TiltyTable/tiltytable/design/assets/site/elevator-mechanism-iso.png

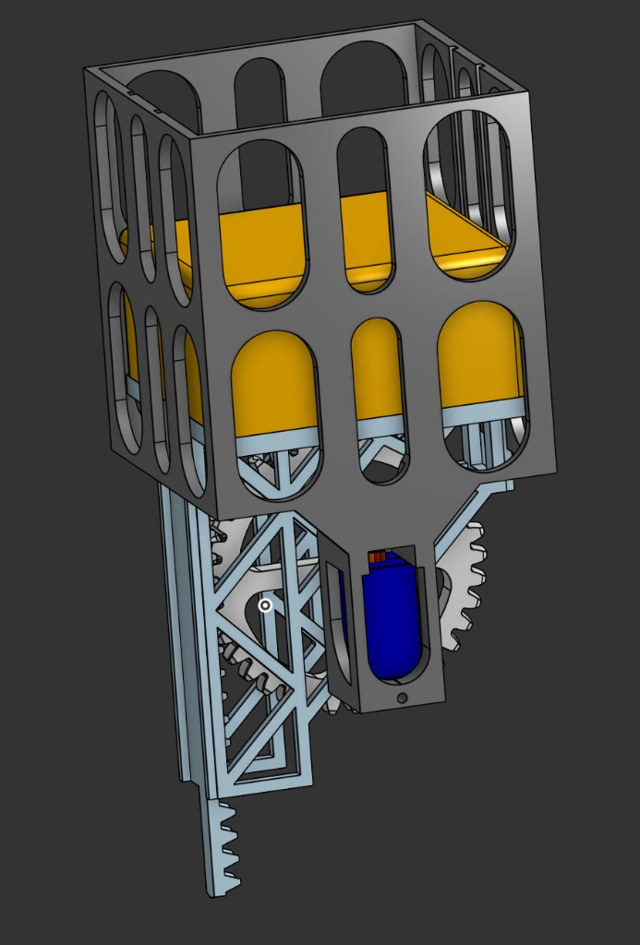
design/assets/site/elevator-mechanism-iso.png
