TiltyTable/tiltytable/docs/assets/stills/build-still-1.jpg

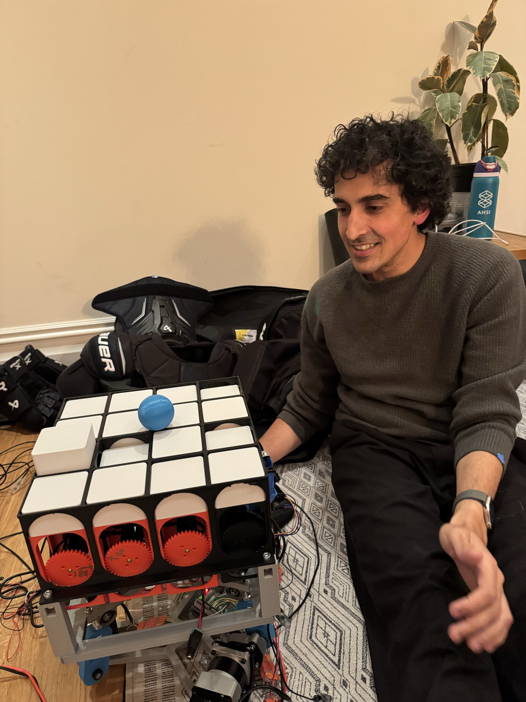
docs/assets/stills/build-still-1.jpg
