TiltyTable/tiltytable/README.md

# TiltyTable arcade game

TiltyTable is a physical 12×12 marble-maze arcade game. A USB trackball tilts
a three-motor Stewart platform, an Arduino-controlled module grid raises and
recesses tiles and drives their LEDs, an Azure Kinect tracks the ball and the
moving table, and a Flask arcade server runs the levels, scoring, projector UI,
and module animations.

This README describes the supported game stack. Retired direct-serial Stewart
programs and firmware are kept under `archive/stewart_legacy/` and must not be
used while the persistent Stewart supervisor is running.

## What the complete game needs

### Hardware and firmware

| Device | Stable device path | Firmware used during the game | Board/FQBN |
| --- | --- | --- | --- |
| Stewart controller | `/dev/arduino-stewart` | `arduino/uim5756_stewart_r4/` | Uno R4 WiFi, `arduino:renesas_uno:unor4wifi` |
| Module servo + LED controller | `/dev/arduino-modules` | `arduino/servo_calib/` | Uno R4 Minima, `arduino:renesas_uno:minima` |
| Trackball | Linux `event-mouse` device | No firmware from this repository | USB HID `13ba:0018` |
| Ball/table camera | Azure Kinect device 0 | Azure Kinect Sensor SDK | USB camera + IMU |

`arduino/uim5756pm_config/` is a temporary one-motor setup sketch. It is used
only to configure each UIM5756PM motor to MCS=4; it is not game firmware.

### Programs running for a complete live game

Start the complete host stack with one launcher. The launcher ensures the
persistent Stewart serial supervisor is running, then starts the integrated
arcade process and projector kiosk:

| Process | Purpose | Owns |
| --- | --- | --- |
| `stewart_supervisor.py` | Persistent serial owner and motion lease server | `/dev/arduino-stewart` |
| `arcade.server` (started by `run_arcade.sh`) | Kinect capture and ball/table tracking; trackball and Stewart control; level logic, scoring, servos, LEDs, and projector UI | Azure Kinect; trackball; supervisor motion lease; `/dev/arduino-modules`; HTTP `:8080` by default |

Do not start `kinect_web_control.py` or a standalone
`stewart_platform_control_*.py` beside the live arcade. Those remain useful as
diagnostic programs, but the arcade owns those devices during a game.

## Essential source and configuration

| Game element | Runtime source | Required configuration |
| --- | --- | --- |
| Trackball + Stewart position control | `arcade/stewart_tilt.py`, `stewart_platform_control_position.py`, `stewart_platform_control_common.py` | Controller defaults; Arduino EEPROM position/calibration |
| Trackball + Stewart velocity control | `stewart_platform_control_velocity.py`, `stewart_platform_control_common.py` | CLI gain, decay, signs, and limits |
| Stewart IK | `analysis/stewart_exp_kinematics.py` | Geometry constants in that module |
| Stewart serial ownership | `stewart_supervisor.py`, `stewart_supervisor_client.py`, `stewart_exp_probe.py` | Supervisor Unix socket; Arduino EEPROM position/calibration |
| Module servos and LEDs | `arcade/hardware.py`, `game_runner.py` | Grid, servo, palette, and LED calibration JSON files below |
| Azure Kinect ball tracking | `arcade/ball_adapters.py`, `kinect_web_control.py`, `ball_tracker.py`, `camera_geometry.py` | `config.json` ball settings |
| Continuous table tracking | `table_pose.py` | `config.json` marker dimensions/threshold; five measured marker locations in `TableGeometry._rebuild()` |
| Arcade game | `arcade/server.py`, `arcade/engine.py`, `arcade/survival_lava.py` | `arcade/levels.json`, `maps/arcade-level-*.json` |
| Arcade cabinet input | `arcade/stewart_tilt.py` | `arcade/config.json` trackball navigation sensitivity |
| Cabinet UI | `arcade/static/` | 854×480 browser kiosk launched by `run_arcade.sh` |

The live module grid requires all of these calibration files:

- `calibration/led_grid_config.json`: all 144 cells mapped to nine physical LED strands.
- `calibration/servo_grid_config.json`: all 144 cells mapped to PCA9685 address/channel pairs.
- `calibration/servo_config_0x40.json` through `servo_config_0x48.json`: recessed, neutral, and extended pulse widths for every mapped servo.
- `calibration/led_palette.json`: game color definitions.
- `calibration/led_color_cal.json`: per-cell/module LED color corrections.

Arcade preflight rejects live mode unless both grids cover 144 cells, all nine
LED strands exist, and every mapped servo has all three calibrated positions.

No active code imports anything under `archive/arduino/`.

### Present in the repository but not required at runtime

- `stewart_exp_probe.py`, `stewart_exp_tune.py`, and the files under
  `calibration/` are bring-up, calibration, and diagnostic tools. Module tools
  require the arcade to be stopped; Stewart tools require the trackball motion
  client to be stopped but normally keep using the supervisor.
- The experimental roller-ball controller is archived under
  `archive/stewart_legacy/python/`; use one of the two active
  `stewart_platform_control_*.py` programs instead.
- `game_runner.py` and `calibration/tilt_table_cli.py` are standalone
  module-grid tools. The arcade imports reusable pieces from `game_runner.py`,
  but neither CLI should run beside the live arcade server.
- `trackball_input_web.py` is a standalone input monitor, not a game service.
- `archive/camera/` contains the MindVision/UVC path and is not used by the Azure
  Kinect game stack.
- `archive/hardware/`, `depth_servo_control.py`, and `extrinsics.json` are older or
  optional experiments. Everything under `archive/arduino/` is outside the
  active game and calibration path.
- `docs/` and `design/` are project-site/design material, not runtime code.

## Host setup

Run commands from the repository root unless a command explicitly changes
directory.

```bash
python3 -m venv .venv
.venv/bin/pip install -r requirements.txt
```

The Azure Kinect path additionally requires the system Azure Kinect Sensor SDK
(`libk4a` and development files) and its Python wrapper:

```bash
.venv/bin/pip install pyk4a
```

The camera service must be able to import `pyk4a` and open device 0. It uses
the Kinect's factory IR camera calibration directly; `extrinsics.json` is not
part of the active ball/table tracking path. RGB capture is disabled, and the
tracker consumes and streams only Active Brightness images—not depth or RGB
frames. Azure Kinect still requires an active depth mode and its OpenGL-backed
depth engine to illuminate and produce Active Brightness; the paired depth
result is generated inside the SDK but is never materialized by this service.

Install Arduino cores and the two non-core sketch libraries:

```bash
arduino-cli core install arduino:renesas_uno
arduino-cli lib install MobaTools@3.1.0
arduino-cli lib install "Adafruit NeoPixel"
```

Install stable serial aliases and non-root trackball access:

```bash
sudo cp udev/99-tiltytable-arduinos.rules /etc/udev/rules.d/
sudo cp udev/99-tiltytable-rollerball.rules /etc/udev/rules.d/
sudo udevadm control --reload-rules
sudo udevadm trigger
sudo usermod -aG plugdev "$USER"
```

Log out and back in after changing group membership. Verify:

```bash
ls -l /dev/arduino-stewart /dev/arduino-modules
ls -l /dev/input/by-id/*event-mouse
```

## Flash the Arduinos

### Uno R4 Minima: module servos and LEDs

This is the only live module-grid sketch. It controls PCA9685 boards
`0x40`–`0x48` and all nine WS2812B strands over one 115200-baud connection.

```bash
arduino-cli compile --fqbn arduino:renesas_uno:minima arduino/servo_calib
arduino-cli upload -p /dev/arduino-modules \
  --fqbn arduino:renesas_uno:minima arduino/servo_calib
```

Do not flash any sketch under `archive/arduino/` for the live game.

### Uno R4 WiFi: configure the three Stewart motors once

The live Stewart firmware assumes every UIM5756PM is configured to **MCS=4**,
which corresponds to 16,000 host steps per crank revolution with the 20:1
gearbox. Mixed MCS settings invalidate all IK step targets.

Mechanically support the loaded platform, stop the supervisor, and connect
exactly one motor UART at a time as documented in
`arduino/uim5756pm_config/README.md`.

```bash
systemctl --user stop tiltytable-stewart-supervisor.service 2>/dev/null || true
arduino-cli compile --fqbn arduino:renesas_uno:unor4wifi arduino/uim5756pm_config
arduino-cli upload -p /dev/arduino-stewart \
  --fqbn arduino:renesas_uno:unor4wifi arduino/uim5756pm_config
arduino-cli monitor -p /dev/arduino-stewart -c baudrate=115200
```

For each of the three motors, issue `get`, then `set 4 CONFIRM`. Power-cycle the
motor supply and verify `get` reports MCS=4 for each motor before continuing.

### Uno R4 WiFi: flash the live Stewart executor

Keep the platform mechanically supported whenever uploading or reopening its
serial device.

```bash
arduino-cli compile --fqbn arduino:renesas_uno:unor4wifi arduino/uim5756_stewart_r4
arduino-cli upload -p /dev/arduino-stewart \
  --fqbn arduino:renesas_uno:unor4wifi arduino/uim5756_stewart_r4
```

After flashing, start the supervisor before using any Stewart Python tool.
Supported clients use its Unix socket and do not open the Arduino directly.

## One-time calibration and bring-up

Never run the arcade server, `game_runner.py`, or two module calibration tools
at the same time: each expects exclusive ownership of `/dev/arduino-modules`.

### 1. Module LED mapping

First confirm all nine strands and determine their real pixel counts:

```bash
.venv/bin/python3 calibration/led_strip_test.py \
  --port /dev/arduino-modules --together
```

Then tag each physical LED pixel to its 12×12 cell. This writes
`calibration/led_grid_config.json`:

```bash
.venv/bin/python3 calibration/led_cal_tool.py \
  --port /dev/arduino-modules
```

### 2. Per-servo motion envelopes

Calibrate recessed, neutral, and extended pulse widths for all nine PCA9685
boards. Run from `calibration/` because this tool's board-config defaults are
relative to its working directory:

```bash
cd calibration
../.venv/bin/python3 servo_tool.py \
  --port /dev/arduino-modules calibrate
cd ..
```

This updates `servo_config_0x40.json` through `servo_config_0x48.json`. Module
servos are pulse-then-release; do not leave them energized against a stop.

To pose-test the calibrated servos, start the interactive tester (its initial
selection is all modules), or run a position once for one module:

```bash
cd calibration
../.venv/bin/python3 servo_tool.py --port /dev/arduino-modules test
../.venv/bin/python3 servo_tool.py --port /dev/arduino-modules test extended --module 0x43
cd ..
```

Inside the tester, use `module all` or `module 0x43` to change the selection,
then enter `recessed`, `neutral`, or `extended`. Modules and servos are
commanded one after another without added pacing, and every servo is released
after it reaches the requested position.

### 3. Servo-to-cell mapping

Visually associate every PCA9685 channel with the LED cell that moves. This
writes `calibration/servo_grid_config.json`:

```bash
cd calibration
../.venv/bin/python3 servo_grid_cal_tool.py \
  --port /dev/arduino-modules
cd ..
```

### 4. LED color matching

Tune the game palette across modules with either the terminal tool or Tk GUI.
Both update `calibration/led_color_cal.json`:

```bash
.venv/bin/python3 calibration/led_color_cal_tool.py \
  --port /dev/arduino-modules

# Alternative GUI; requires python3-tk
.venv/bin/python3 calibration/led_color_cal_gui.py \
  --port /dev/arduino-modules
```

### 5. Validate the complete module grid

```bash
.venv/bin/python3 -m arcade.preflight \
  --hardware --module-port /dev/arduino-modules --port 8081
```

An optional physical smoke test is available, but it moves every calibrated
channel and should be run only with an operator watching the table:

```bash
.venv/bin/python3 calibration/quick_test.py /dev/arduino-modules
```

### 6. Stewart crank and physical-level calibration

Install and start the persistent supervisor:

```bash
mkdir -p ~/.config/systemd/user
cp systemd/tiltytable-stewart-supervisor.service ~/.config/systemd/user/
systemctl --user daemon-reload
systemctl --user enable --now tiltytable-stewart-supervisor.service
systemctl --user status tiltytable-stewart-supervisor.service
```

The supplied service contains absolute `/home/zipline/tiltytable` and
`/home/zipline/bin/arduino-cli` paths. Edit the copied service if the checkout
or `arduino-cli` lives elsewhere. Keep `Restart=no`: an automatic restart can
reopen serial while the platform is loaded.

The Freenove V5 WiFi USB bridge requires DTR asserted, so the supervisor and
supplied service default to `--dtr on`. Pass `--dtr off` explicitly for boards
where opening with DTR can reset the controller.

Confirm the firmware through a read-only supervisor lease:

```bash
.venv/bin/python3 stewart_exp_probe.py --check-firmware
```

Run the tuning session with the platform mechanically protected:

```bash
.venv/bin/python3 stewart_exp_tune.py
```

If Arduino `STATUS` is not calibrated, the tool starts interactive per-crank
vertical calibration. Runtime `nudge`, `profile`, `threshold`, and `agility`
commands operate only for the current session and do not create tuning state.
The active `stewart_platform_control_position.py` and
`stewart_platform_control_velocity.py` programs use their CLI settings and
firmware calibration directly.

Every supported motion client gets the current absolute motor positions from
the Arduino/supervisor during startup before constructing its initial IK pose.
The platform controllers resume that held pose by default. Pass
`--zero-on-start` to move to the canonical level pose before accepting input.
The live R4 executor and supervisor communicate at 230400 baud.
Position control defaults to 9 degrees maximum tilt, 0.04 degrees per input
count, 60 degrees/s crank speed, 500 degrees/s2 crank acceleration, zero input
deadband, a 90 Hz update rate, and no startup confirmation. Pass `--no-yes`
to require the `START` confirmation.

### 7. Azure Kinect ball and table tracking

Mount six retroreflective fiducials: one at each table corner and one more
on each of two adjacent edges, in the geometry documented at the top of
`table_pose.py`.
Verify the measured marker-center locations in `TableGeometry._rebuild()`;
the four corner fiducials define the cell-map bounds, so no separate table
length configuration is needed. Thresholds, ball radius, and camera settings
live in `config.json`.

The tracking algorithms are image-space-only. RGB capture is forced off, and
neither the integrated arcade nor the diagnostic camera page reads or streams
depth/RGB frames. `/stream/ir.mjpg`, `/stream/tracker.mjpg`, and
`/stream/pose.mjpg` contain only raw or annotated Active Brightness images.

Set `table_pose.marker_world_points` in `config.json` to the measured center
of each fiducial, in millimetres: `corner_origin`, `corner_x`, `corner_xy`,
`corner_y`, `edge_x`, and `edge_y`. Each value is `[x, y, z]` in the table
frame. Place the two edge markers on adjacent edges to break the square's
mirror ambiguity.

Start the camera service on port 8080:

```bash
.venv/bin/python3 kinect_web_control.py --http-port 8080
```

Open `http://127.0.0.1:8080/` and tune the marker and ball IR thresholds. The
service is ready for the game when these endpoints report table tracking and a
detected ball with a grid cell:

```bash
curl -s http://127.0.0.1:8080/api/pose/state
curl -s http://127.0.0.1:8080/api/state
```

`config.json` currently enables ball tracking. If a different config is used,
pass `--ball-tracking` or set `ball.ball_tracking` to `true`.

## Run the complete game

After completing hardware setup, calibration, and the one-time supervisor
installation above, launch the entire game from the repository root:

```bash
./run_arcade.sh
```

The launcher runs hardware preflight, starts the persistent Stewart supervisor
user service if needed, and starts one arcade process. That arcade process owns
the Azure Kinect tracker, trackball/Stewart motion client, module servos and
LEDs, game engine, HTTP server, and projector kiosk. It initializes Stewart IK
from the current Arduino motor positions and uses the firmware's EEPROM
calibration directly.

When launched from SSH, `run_arcade.sh` attaches the arcade process to the local
GPU-backed projector display (`:0`) before starting Kinect capture. The Azure
Kinect depth engine requires that OpenGL display even though the integrated
tracker does not consume depth frames or render preview windows; Active
Brightness illumination still comes from that engine. An SSH-forwarded display
such as `localhost:10.0` is not sufficient.

Set `TILTYTABLE_ARCADE_PORT` only when the default port `8080` is unavailable:

```bash
TILTYTABLE_ARCADE_PORT=8081 ./run_arcade.sh
```

Use `--no-kiosk` to run only the server and open
`http://127.0.0.1:8080/` manually (or the port selected with
`TILTYTABLE_ARCADE_PORT`).

Current game behavior:

- The arcade process exclusively drives module servos and LEDs.
- The in-process Stewart adapter reads the trackball and enables tilt during an
  active level.
- The in-process Kinect adapter drives the automatic Floor-is-Lava survival
  mechanics.

## Arcade diagnostics

Validate maps and Python behavior:

```bash
.venv/bin/python3 -m arcade.preflight --port 8081 --hardware
.venv/bin/python3 -m unittest discover -s tests -v
```

Apply one map without the arcade server (exclusive module access required):

```bash
.venv/bin/python3 game_runner.py maps/arcade-lava-survival.json --once
```

## Runtime ownership and shutdown

- Only `stewart_supervisor.py` opens `/dev/arduino-stewart`.
- Only one motion client may hold the supervisor motion lease.
- Only the arcade server or one calibration/diagnostic tool may open
  `/dev/arduino-modules`.
- Stop the arcade before module calibration.
- Stop the Stewart motion client before tuning; keep the supervisor running.
- Stop the supervisor and mechanically support the table before flashing the
  Uno R4 WiFi, changing motor wiring, or cycling motor power.
- Stewart `HOLD` keeps the loaded platform energized. USB loss, controller
  reset, or power loss can release it.
- Module firmware automatically releases stalled servo channels; host code
  also pulses and releases each move.

Additional detail is available in `arcade/README.md`,
`arduino/uim5756_stewart_r4/README.md`, `maps/README.md`, and
`STEWART_PLATFORM_CONTROL_CHANGES.md`.
