TiltyTable/tiltytable/hardware/arduino/README.md

# hardware/arduino

Sketches that lived here were archived to `arduino/archive/` (2026-07-11).

Live module firmware: `arduino/servo_calib/`.
Live Stewart firmware: `arduino/uim5756pm_stewart_exp/`.
