TiltyTable/tiltytable/arduino/uim5756pm_stewart/README.md

# UIM5756PM 3-Axis Stewart Controller

Arduino sketch for three UIM5756PM pulse-direction motors on a 3-axis
roll/pitch/heave Stewart-style platform. Runs on the **Uno R3**
(`/dev/arduino-stewart` / `/dev/ttyACM0`).

The Uno R4 Minima is a separate board that drives the module-grid PCA9685
servos and WS2812 LEDs (`arduino/servo_calib/`).

## Calibration (required)

Two methods:

### Interactive (recommended)

Jog each crank under power until vertical by eye:

```bash
.venv/bin/python3 stewart_calibrate.py
```

Per axis: **←/→** fine jog, **↑/↓** coarse jog, **Enter** when straight up.

Firmware commands: `cal_begin` → `enable N` → `jog` → `cal_axis N` → `cal_finish`.

### Legacy (all cranks manually up first)

```bash
.venv/bin/python3 stewart_calibrate.py --legacy --yes
```

Or send `calibrate` after manually pointing all cranks straight up.

That pose is recorded as heave `+30 mm` at roll=pitch=0, with crank
angle `90°` relative to the IK model (`NEUTRAL_CRANK_DEG = 180°` is
horizontal).

### Calibration persistence across app restarts

`roller_ball.py --hold-on-exit` now sends `hold` followed by `persist`.
Firmware stores the settled step counters and logical pose in EEPROM. On the
next **external reset** (USB serial DTR / reset button), it restores that
position with motors initially disabled; `roller_ball.py` detects
`calibrated 1 restored 1`, enables at the same target, and skips the TUI.

Power-on, brown-out, and watchdog resets never trust EEPROM and require
calibration. If motor power is cycled without also resetting the Uno, send
`forget` before restarting motion—the Uno cannot electrically detect a
separate motor-supply power cycle.

Host helpers:

```bash
python3 stewart_cli.py
# or one-shot:
python3 stewart_calibrate.py --port /dev/arduino-stewart
```

## Wiring

Two cables per motor (Amazon / UIM344 Fig 0-6 harness — **no purple**):

- Power cable: red and black, 22 AWG.
- Signal cable: brown / gray / yellow / blue / black / white / green, 26 AWG.

| Motor wire | Driver pin | Label | Connect to |
| --- | ---: | --- | --- |
| Red | 1 | `+24-48 VDC` | Motor power supply positive |
| Black | 2 | `0 VDC` | Motor power supply negative |
| **Brown** | 3 | `COM` | Arduino `5V` |
| **Gray** | 4 | `DIR` | Arduino DIR pin for that axis |
| **Yellow** | 5 | `PLS` | Arduino PLS pin for that axis |
| **Blue** | 6 | `ENA` | Arduino ENA pin for that axis |
| Black (signal) | 7 | `GND` | Arduino `GND` (+ supply negative) |
| White | 8 | `TX` | Leave unconnected (config only) |
| Green | 9 | `RX` | Leave unconnected (config only) |

Arduino control pins (Uno R3, 2026-07-09 harness):

| Axis | `PLS` (Yellow) | `DIR` (Gray) | `ENA` (Blue) |
| --- | ---: | ---: | ---: |
| 0 | D2 | D3 | D4 |
| 1 | D7 | D8 | D9 |
| 2 | D11 | D12 | D13 |

With Brown `COM` connected to Arduino `5V`, the Arduino output pins sink
current through the driver's opto-isolated inputs. The sketch uses
`ENA_ACTIVE_LOW = true`.

### Serial open resets the Uno (by design for this stack)

Opening `/dev/arduino-stewart` (`ttyACM*`) **resets the Uno R3** on the Jetson:
CDC-ACM pulses DTR → RESET. That clears firmware `calibrated` / enable.
We are **not** disabling autoreset in hardware.

**Workflow:** after every serial open that needs motion, re-send `calibrate`
with the cranks still in the physical reference pose (straight up), then
`enable`. Roller ball: always use `--calibrate-on-start`.

UIM344 / UIM5756PM require step pulse width **> 4 µs** (manual). The sketch
uses `setMinPulseWidth(5)`. All three motors are configured to **MCS=8**:
200 × 8 × 20:1 = **32000 pulses / crank revolution**. Use the dedicated
`arduino/uim5756pm_config/` sketch to query/set one motor at a time.

Keep grounds common: Arduino `GND`, each signal-black `GND`, and the motor
power supply negative. Do not power the motors from the Arduino.

## Configure Before Use

Edit these constants near the top of `uim5756pm_stewart.ino`:

- `STEPS_PER_CRANK_REV`: motor pulses per crank revolution (32000 at MCS=8, 20:1).
- Platform geometry (`TABLE_ROD_RADIUS_MM`, `CRANK_RADIUS_MM`, `ARM_LENGTH_MM`, …).
- `CALIBRATE_CRANK_DEG` / `CALIBRATE_HEAVE_MM` (must stay consistent with geometry).
- `MAX_ROLL_DEG`, `MAX_PITCH_DEG`, and heave limits.
- Speed / acceleration (`MAX_CRANK_SPEED_DEG_S`, `MAX_CRANK_ACCEL_DEG_S2`).

See also `analysis/KINEMATICS.md`.

## Serial Commands

Use `115200` baud with newline enabled.

```text
calibrate                 # cranks straight up = max heave (alias: zero)
hold                      # enable all drivers and hold current positions
enable [axis]
disable [axis]
pose <roll_deg> <pitch_deg> <heave_mm>
vel <roll_deg_s> <pitch_deg_s> <heave_mm_s>
angle <a0_deg> <a1_deg> <a2_deg>
steps <s0> <s1> <s2>
jog <axis> <pulses>
status
persist
forget
help
```

Example after calibration:

```text
calibrate
enable
pose 0 0 0
pose 3 0 0
status
disable
```

## Upload

```bash
arduino-cli compile --fqbn arduino:avr:uno arduino/uim5756pm_stewart
arduino-cli upload -p /dev/arduino-stewart --fqbn arduino:avr:uno arduino/uim5756pm_stewart
```

## First Power-Up

1. Flash firmware; confirm `status` shows `calibrated 0`.
2. Manually set cranks straight up; send `calibrate`; confirm `calibrated 1`.
3. With motor power still cautious, `enable` then small `pose` / `jog` tests.
4. Verify direction; flip `DIR_INVERT[i]` if an axis is backwards.
