TiltyTable/tiltytable/arcade-title-check.png

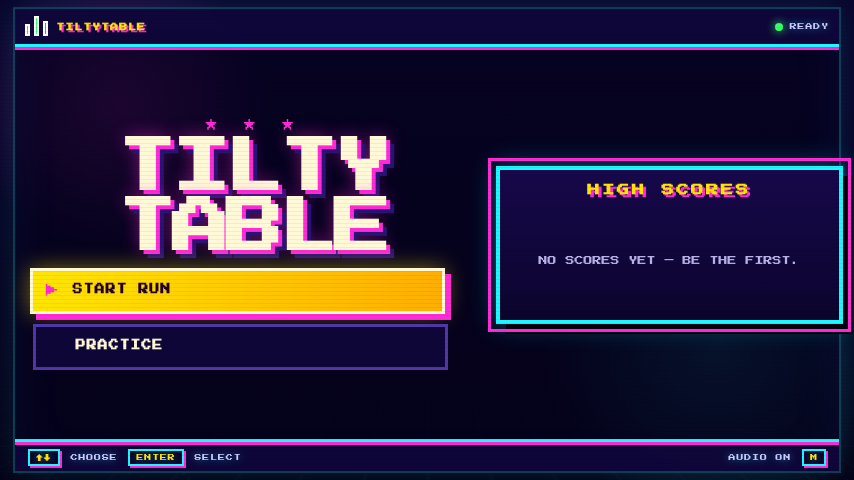
arcade-title-check.png
