TiltyTable/tiltytable/design/assets/site/elevator-mechanism-front.png

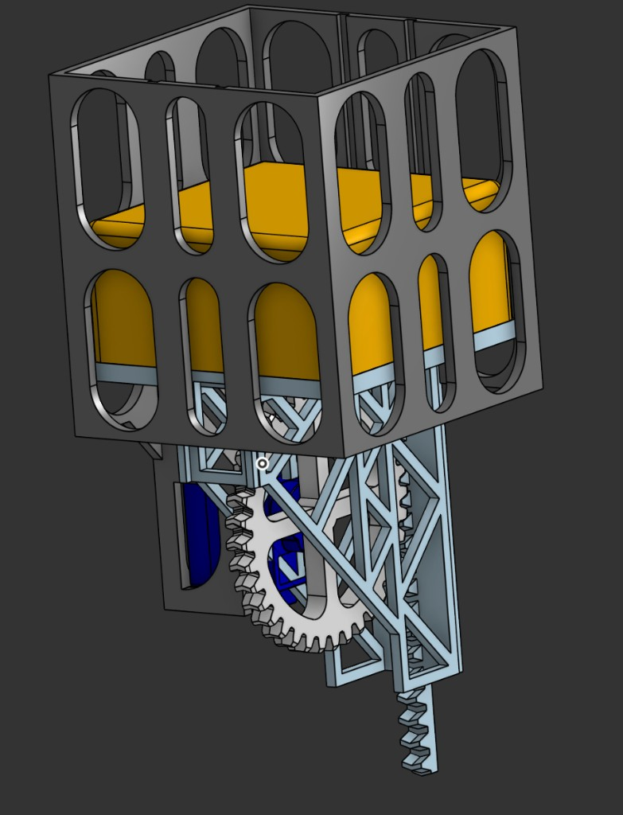
design/assets/site/elevator-mechanism-front.png
