TiltyTable/tiltytable/design/assets/site/elevator-mechanism-side.png

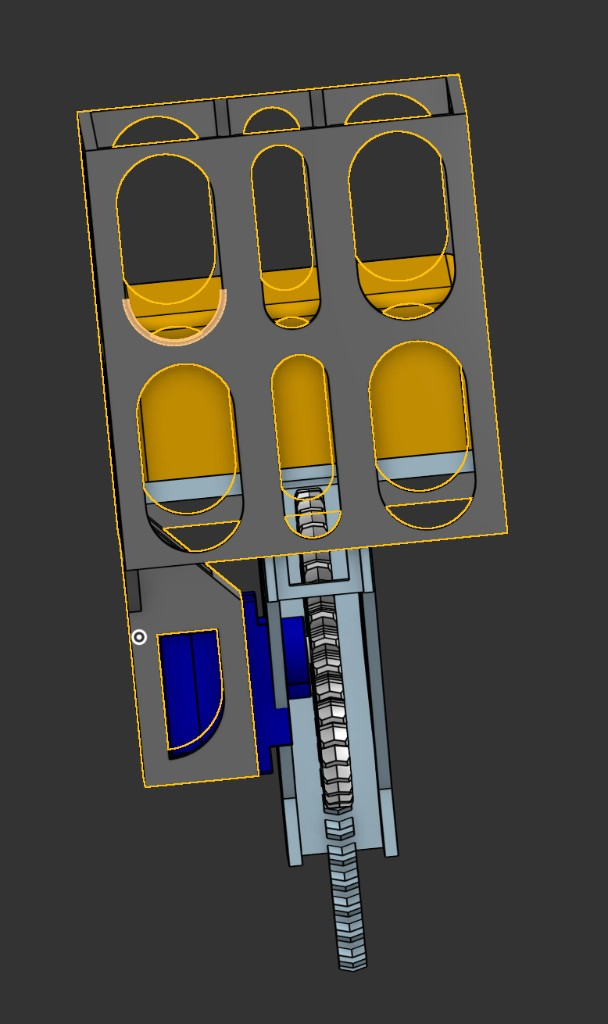
design/assets/site/elevator-mechanism-side.png
