TiltyTable/tiltytable/docs/assets/stills/main-demo-poster.jpg

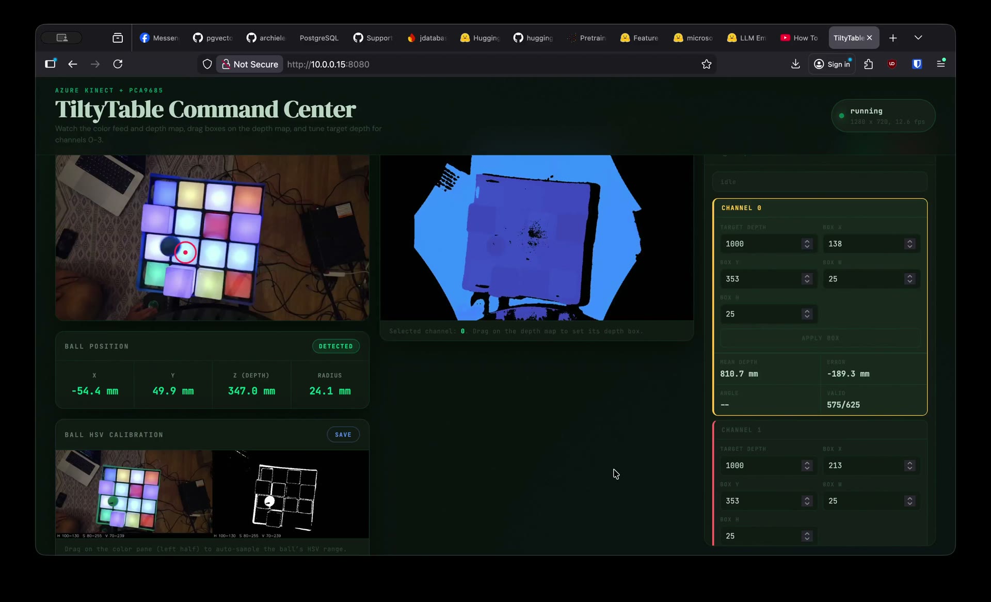
docs/assets/stills/main-demo-poster.jpg
