TiltyTable/tiltytable/docs/assets/stills/reconfiguration-demo-poster.jpg

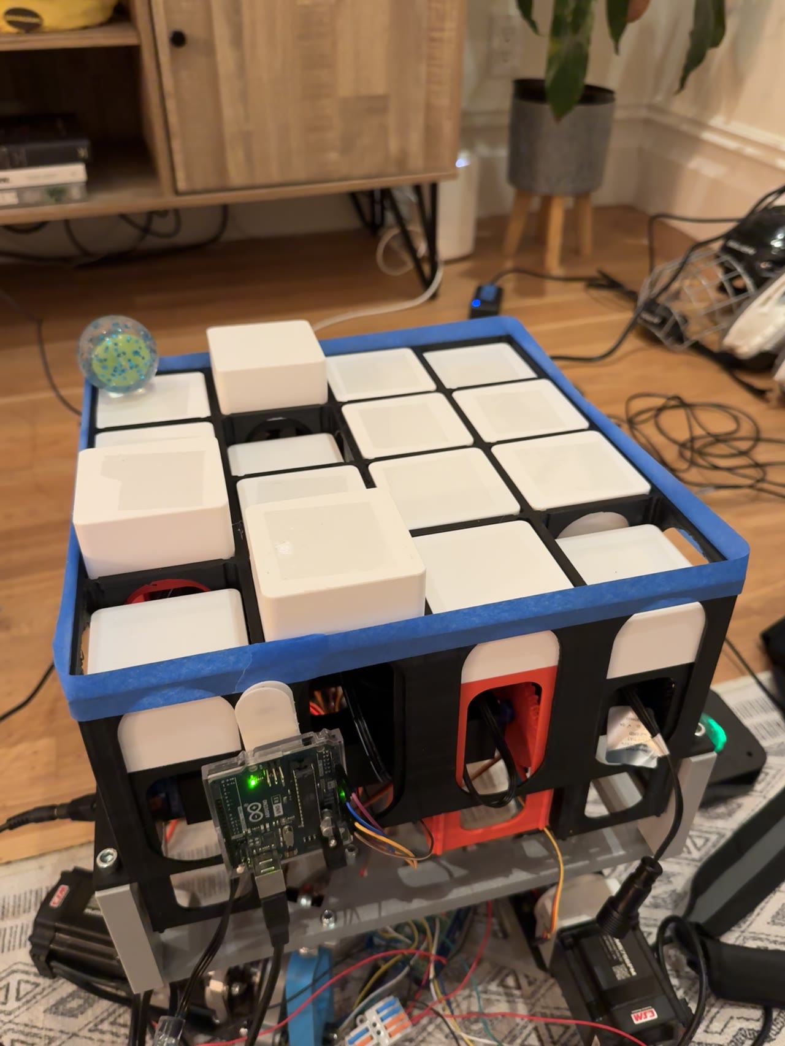
docs/assets/stills/reconfiguration-demo-poster.jpg
