TiltyTable/tiltytable/docs/assets/stills/roller-ball-control-poster.jpg

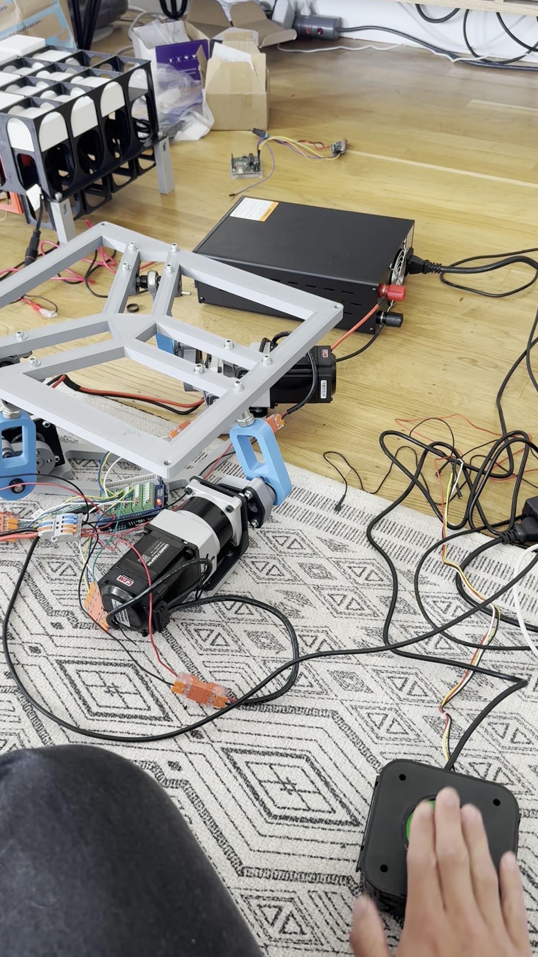
docs/assets/stills/roller-ball-control-poster.jpg
