TiltyTable/tiltytable/docs/assets/stills/total-system-cad.jpg

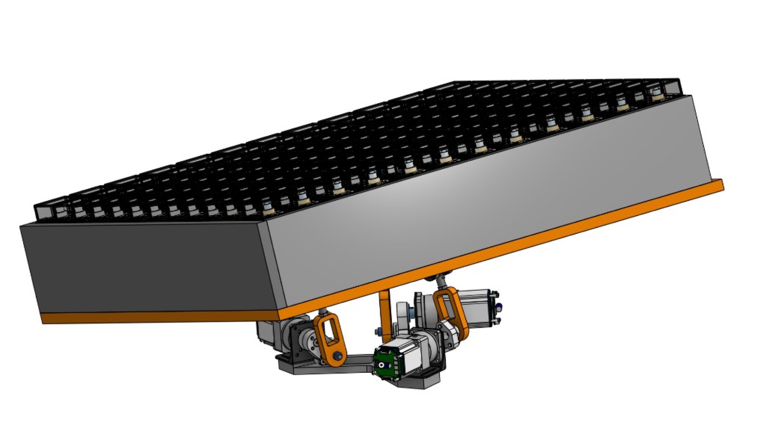
docs/assets/stills/total-system-cad.jpg
