TiltyTable/tiltytable/docs/assets/stills/build-still-2.jpg

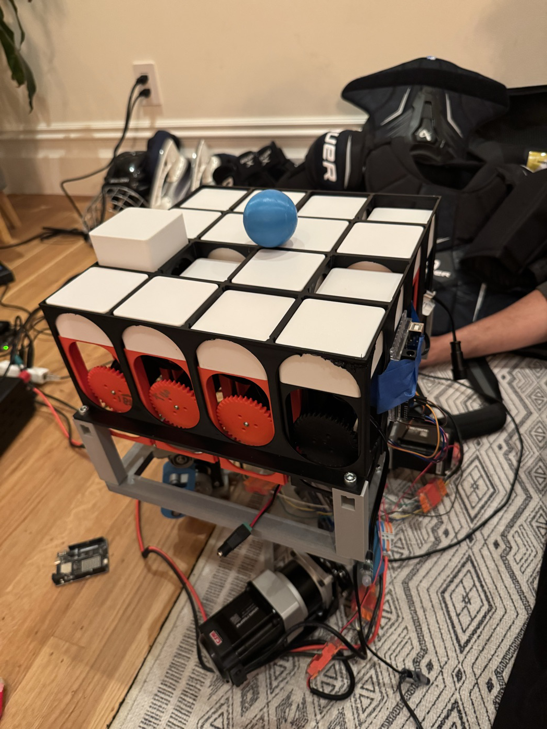
docs/assets/stills/build-still-2.jpg
