TiltyTable/tiltytable/docs/assets/stills/build-still-3.jpg

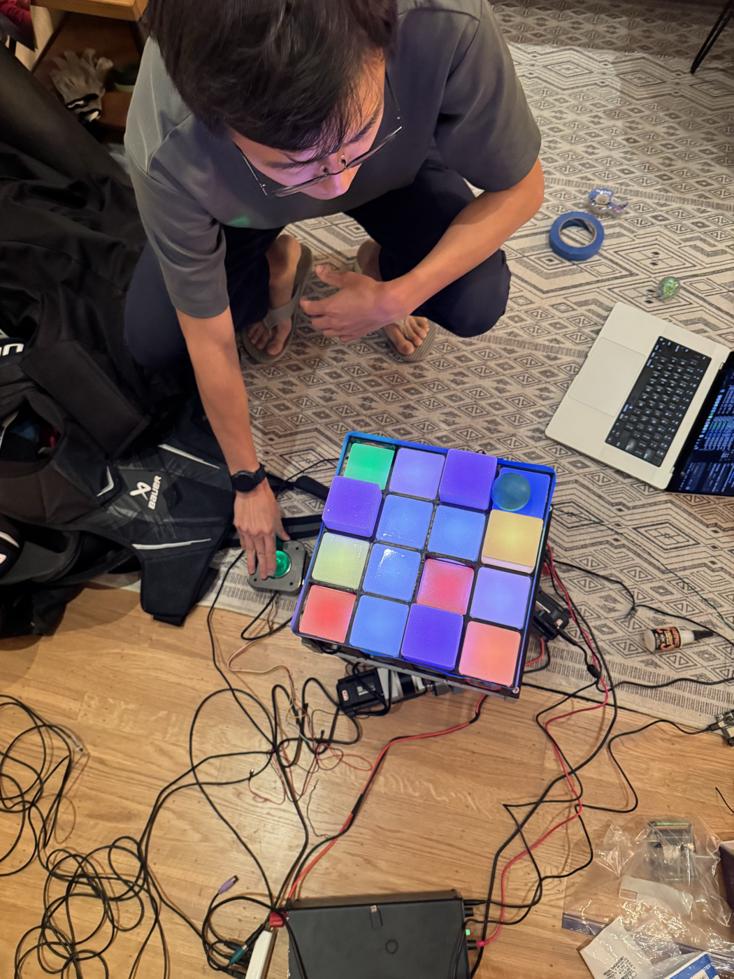
docs/assets/stills/build-still-3.jpg
