TiltyTable/tiltytable/STEWART_PLATFORM_CONTROL_CHANGES.md

# Stewart platform control analysis and changes

Date: 2026-07-15

## Outcome

The experimental inverse-kinematics equations close correctly, but the old
control path did not make `(roll=0, pitch=0)` a unique physical command.
Free heave, two crank branches per leg, path-dependent optimization, and large
persisted motor offsets could all cause a later logical zero to use different
motor coordinates from the starting zero. The new controllers use one shared
Arduino step executor, deterministic symmetric branch selection at calibration,
free-heave host IK, and zero motor offsets unless corrections are explicitly
provided on the command line.

## Analysis findings

### Experimental host IK

- `analysis/stewart_exp_kinematics.py` produces valid arm closure. A grid of
  13,845 feasible samples over roll, pitch, and heave had a worst numerical arm
  length error of approximately `4.3e-14 mm`.
- A roll/pitch target is intentionally non-unique because heave is free and
  every leg has two closure branches. The local optimizer uses the preceding
  solution, so the actuator result depends on the path taken to the endpoint.
- Existing tests documented that non-uniqueness but did not require a
  zero/non-zero/zero sequence to reproduce the original motor coordinates.
- Symmetric poses at the crank-up dead center had branch scores that differed
  only by floating-point roundoff. That could select different branches for
  otherwise identical legs. The solver now quantizes only the score's
  continuity terms before comparing branch combinations and uses the branch
  tuple as a deterministic final tie-break.

### Other code-path issues found and archived

- The legacy firmware's `solveCrankAngle()` clamps an out-of-range cosine
  into `[-1, 1]` rather than rejecting the unreachable triangle. The newer
  experimental host solver correctly rejects it. The new controllers do not
  use the production firmware IK.
- `ball_balancer.py` sends `pose ... heave=0`, while the current production
  geometry declares a minimum heave of 12 mm and its own tests show the level
  zero-heave pose exceeds the rod-end limit. That client also does not read the
  rejection, so a failed return-to-level command can be silent.
- Arduino step counters are open-loop pulse coordinates, not encoder feedback.
  Passing software tests cannot rule out missed steps, gearbox backlash, link
  compliance, or a calibration error on the physical machine.

## New control architecture

Both public Python programs use the same existing Arduino firmware:

```text
arduino/uim5756_stewart_r4/uim5756_stewart_r4.ino
```

That firmware remains a calibration-gated absolute-step executor. It does not
contain a second copy of IK. The shared Python layer owns trackball decoding,
roll/pitch targets, free-heave IK, branch continuity, serial commands, arming,
and hold-on-exit behavior.

The Python programs connect exclusively through `stewart_supervisor.py`, which
keeps a no-DTR serial owner alive. Opening an Uno directly may reset it,
invalidate the persisted position state, and require calibration, so the live
tools no longer expose a direct-serial fallback.

`ExpLink.open()` now performs `EXP?` followed by `STATUS` and retains that
startup snapshot. Every live motion client constructs its initial IK pose from
the returned `s0/s1/s2` coordinates (with any explicit step offsets applied)
before it plans or sends a target. The profile utility also reads and displays
`STATUS` before changing the motion profile.

## Files modified

### `analysis/stewart_exp_kinematics.py`

Made symmetric branch selection deterministic. This prevents tiny trigonometric
roundoff differences between leg azimuths from sending identical legs down
different branches when leaving the calibration dead center.

### `stewart_platform_control_common.py`

Added the common host layer used by both controllers:

- Linux `REL_X`/`REL_Y` parsing committed at `SYN_REPORT` boundaries.
- Input accumulation that retains early events until the next control tick.
- Experimental firmware identity checking through the existing `ExpLink`.
- Interactive calibration when firmware state is not already calibrated.
- Runtime crank speed/acceleration setup, arming, and final `HOLD`.
- A configurable startup heave transition so the table leaves max-heave dead
  center before tilt control.
- Canonical zero handling: an exact `(0, 0)` request settles back to the
  configured startup heave, while nonzero endpoints retain free-heave IK.
- Radially bounded roll/pitch targets and bounded IK waypoints.
- Free-heave IK with continuity and the 12-degree crank target limit.
- Explicit optional motor step offsets, defaulting to zero.

### `stewart_platform_control_position.py`

Added direct roll/pitch position control:

- Positive X trackball counts increase pitch by default.
- Positive Y trackball counts increase roll by default.
- Counts accumulate into an absolute platform target.
- `--degrees-per-count`, axis signs, deadband, maximum tilt, and motion profile
  are configurable.

### `stewart_platform_control_velocity.py`

Added inertial angular-velocity control:

- A positive X swipe adds positive pitch velocity by default.
- A positive Y swipe adds positive roll velocity by default.
- Velocity integrates into the absolute roll/pitch target.
- Velocity decays exponentially to zero using `--velocity-decay-s`.
- Outward radial velocity is removed at the maximum tilt boundary to prevent
  limit windup.
- Swipe gain, decay, speed limit, epsilon, signs, and deadband are configurable.

### `tests/test_stewart_platform_control.py`

Added tests for direct axis mapping, radial pose clamping, velocity impulse
mapping, exponential decay, outward-velocity removal, complete trackball frame
handling, and deterministic symmetric branch selection during the startup
heave transition.

### Supervisor startup-state enforcement

- `stewart_exp_probe.py`: made `ExpLink` supervisor-only and captured a parsed
  `startup_status` as part of every live connection.
- `stewart_exp_tune.py` and `stewart_platform_control_common.py`: initialize
  their current IK pose from that supervisor-owned snapshot.
- `stewart_exp_profile.py`: reads and prints `STATUS` before profile commands.
- `tests/test_stewart_supervisor.py`: verifies that opening an `ExpLink`
  captures nonzero signed motor positions without substituting zeroes.

### Archived legacy stack

Moved the direct-serial Python programs, their roller test, and the old
firmware-hosted IK sketch into `archive/stewart_legacy/`. These programs could
reset or compete with the permanent supervisor and used a different geometry
and protocol. `archive/stewart_legacy/README.md` records the boundary and the
risk. Root and firmware documentation now point to the supervisor-owned stack.

### Game-path and Arduino archive cleanup

- Rebuilt the root `README.md` around the actual game path: the two Arduino
  images, four long-running host processes, calibration order, ownership rules,
  and exact live-game startup commands.
- Removed the last active import of archived
  `pca9685_serial_servo/servo_write.py`. `depth_servo_control.py` now owns its
  small baud-rate, termios, and ready-wait helpers, and
  `kinect_web_control.py` imports those helpers from the active module.
- Moved all retired sketches and tools from `arduino/archive/` to
  `archive/arduino/`, and updated their internal example paths. Nothing under
  that directory is imported by the active game.

## Running the controllers

Start the persistent serial supervisor if it is not already running:

```bash
.venv/bin/python3 stewart_supervisor.py
```

Direct position control:

```bash
.venv/bin/python3 stewart_platform_control_position.py
```

Decaying angular-velocity control:

```bash
.venv/bin/python3 stewart_platform_control_velocity.py
```

Useful low-risk first tests:

```bash
.venv/bin/python3 stewart_platform_control_position.py \
  --max-tilt 2 --degrees-per-count 0.02

.venv/bin/python3 stewart_platform_control_velocity.py \
  --max-tilt 2 --velocity-per-count 0.2 --max-velocity 5
```

Use `--roll-sign -1` or `--pitch-sign -1` if a physical axis moves opposite
the desired convention.

## Validation

The implementation was checked with:

```bash
.venv/bin/python3 -m unittest discover -s tests -v
.venv/bin/python3 -m compileall -q -x '(^|/)(archive|camera/mvsdk.py)' .
arduino-cli compile --fqbn arduino:renesas_uno:unor4wifi \
  arduino/uim5756_stewart_r4
```

The 41 focused Stewart IK, controller, supervisor, and tuning tests report
`OK`. The R4 executor and R4 motor configurator compile for
`arduino:renesas_uno:unor4wifi`; the retained rollback sketch also compiles for
`arduino:avr:uno`. Python byte-compilation exits successfully. Hardware motion
and reset-state restoration were not exercised on the loaded platform.

Hardware motion was not performed during this change. The first live run should
be mechanically supported, limited to 2 degrees, and checked for axis signs,
missed steps, branch clearance, and repeatable physical level before increasing
the envelope or speed.

## Uno R4 WiFi migration

The Stewart controller was subsequently replaced with the connected Uno R4
WiFi (`arduino:renesas_uno:unor4wifi`, USB `2341:1002`, serial
`3CDC75443C14`). The active executor now lives in
`arduino/uim5756_stewart_r4/`; the R3 sketch is retained only for rollback.

- Preserved the PLS/DIR/ENA pin mapping, MCS=4 scale, safety gates, target-jump
  limit, and supervisor wire protocol.
- Replaced AVR `MCUSR`, `.noinit`, `.init3`, and watchdog handling with RA4M1
  reset-status capture. Unsafe resets cannot restore open-loop coordinates.
- Updated the one-motor MCS configurator for the R4 SoftwareSerial API.
- Updated the udev identity, FQBNs, active firmware paths, and operator docs.
- Replaced polling-based AccelStepper in the R4 executor with MobaTools 3.1.0.
  Its RA4M1 backend allocates a GPT timer and services all three STEP/DIR axes
  independently of the serial loop. Proportional per-axis speed and ramp
  profiles preserve live 60 Hz retargeting, which `MoToSyncStepper` does not
  allow while a synchronized move is active.
- Kept the validated 40°/s default and 90°/s maximum. At MCS=4 those are about
  1,778 and 4,000 pulses/s; the R4 timer backend removes polling as the likely
  limit, while motor torque, load, gearbox behavior, and open-loop missed steps
  remain practical constraints.
