TiltyTable/tiltytable/arcade/hardware.py

from __future__ import annotations

import copy
import json
import threading
import time
from collections import OrderedDict
from pathlib import Path
from typing import Any

from game_runner import (
    BOARD_ORDER,
    Link,
    Table,
    cell_key_to_row_col,
    load_table_configs,
    normalize_addr,
    parse_map,
    tick_dynamic_cells,
)

START_COLOR = "#00E5FF"
END_COLOR = "#FF00AA"
DEFAULT_ARCADE_CONFIG = Path(__file__).with_name("config.json")
LED_UPDATE_QUEUE_CAPACITY = 256
MOTION_UPDATE_QUEUE_CAPACITY = 256


def load_module_start_delay_ms(
    config_path: Path = DEFAULT_ARCADE_CONFIG,
) -> int:
    with Path(config_path).open(encoding="utf-8") as config_file:
        config = json.load(config_file)
    value = config.get("modules", {}).get("start_delay_ms")
    if isinstance(value, bool) or not isinstance(value, int) or value < 0:
        raise ValueError("arcade modules.start_delay_ms must be a non-negative integer")
    return value


def load_unstick_config(
    config_path: Path = DEFAULT_ARCADE_CONFIG,
) -> dict[str, float]:
    with Path(config_path).open(encoding="utf-8") as config_file:
        raw = json.load(config_file).get("unstick", {})
    return {
        "lift_fraction": float(raw.get("lift_fraction", 0.15)),
        "lift_s": max(0.0, float(raw.get("lift_ms", 180)) / 1000.0),
        "neutral_s": max(0.0, float(raw.get("neutral_ms", 100)) / 1000.0),
    }


class HardwareError(RuntimeError):
    pass


class BaseTableHardware:
    def initialize(self) -> None:
        raise NotImplementedError

    def load_level(
        self, map_path: Path, start_cell: str, end_cell: str | None
    ) -> None:
        raise NotImplementedError

    def begin_play(self) -> None:
        raise NotImplementedError

    def pause(self) -> None:
        raise NotImplementedError

    def cancel_load(self) -> None:
        raise NotImplementedError

    def apply_cell_updates(self, updates: list[dict[str, Any]]) -> None:
        raise NotImplementedError

    def apply_cell_updates_now(self, updates: list[dict[str, Any]]) -> None:
        """Apply a small terminal update before play is paused."""
        self.apply_cell_updates(updates)

    def unstick_cell(self, row: int, col: int) -> bool:
        raise NotImplementedError

    def flash_all_leds(
        self,
        duration_s: float = 1.0,
        restore_color: str = "#567DBB",
    ) -> bool:
        raise NotImplementedError

    def shutdown(self) -> None:
        raise NotImplementedError

    def snapshot(self) -> dict[str, Any]:
        raise NotImplementedError


class SimulatedTableHardware(BaseTableHardware):
    def __init__(self) -> None:
        self.ready = False
        self.busy = False
        self.error = ""
        self.playing = False
        self.level = ""
        self.unstick_calls: list[tuple[int, int]] = []
        self.flash_calls = 0
        self.flash_restore_colors: list[str] = []

    def initialize(self) -> None:
        self.ready = True
        self.error = ""

    def load_level(
        self, map_path: Path, start_cell: str, end_cell: str | None
    ) -> None:
        self.level = map_path.name
        self.busy = False
        self.playing = False

    def begin_play(self) -> None:
        self.playing = True

    def pause(self) -> None:
        self.playing = False

    def cancel_load(self) -> None:
        self.busy = False
        self.playing = False

    def apply_cell_updates(self, updates: list[dict[str, Any]]) -> None:
        return

    def unstick_cell(self, row: int, col: int) -> bool:
        self.unstick_calls.append((row, col))
        return self.playing

    def flash_all_leds(
        self,
        duration_s: float = 1.0,
        restore_color: str = "#567DBB",
    ) -> bool:
        del duration_s
        self.flash_calls += 1
        self.flash_restore_colors.append(restore_color)
        return self.playing

    def shutdown(self) -> None:
        self.ready = False
        self.playing = False

    def snapshot(self) -> dict[str, Any]:
        return {
            "mode": "simulation",
            "ready": self.ready,
            "busy": self.busy,
            "playing": self.playing,
            "error": self.error,
            "level": self.level,
        }


class ModuleGridHardware(BaseTableHardware):
    """Long-lived, exclusive module-grid owner.

    Level loads run in a worker because applying 144 LEDs/servos takes several
    seconds. All board selection + command sequences are serialized by
    ``_io_lock`` so blink/dynamic activity cannot interleave I2C board changes.
    """

    def __init__(
        self,
        port: str = "/dev/arduino-modules",
        baud: int = 115200,
        dry_run: bool = False,
        arcade_config_path: Path = DEFAULT_ARCADE_CONFIG,
    ) -> None:
        self.port = port
        self.baud = baud
        self.dry_run = dry_run
        self.module_start_delay_s = (
            load_module_start_delay_ms(arcade_config_path) / 1000.0
        )
        self.unstick_config = load_unstick_config(arcade_config_path)
        self.link: Link | None = None
        self.table: Table | None = None
        self.ready = False
        self.busy = False
        self.playing = False
        self.error = ""
        self.level = ""

        self._state_lock = threading.Lock()
        self._io_lock = threading.Lock()
        self._stop = threading.Event()
        self._animation_stop = threading.Event()
        self._generation = 0
        self._blink_entries: list[dict[str, Any]] = []
        self._dynamic: list[dict[str, Any]] = []
        self._play_started_at: float | None = None
        self._unstick_busy = False
        self._effect_busy = False
        self._servo_release_lock = threading.Lock()
        self._servo_release_done = threading.Event()
        self._servo_release_done.set()
        self._load_phase = ""
        # LED-only effects must never hold up the camera/game tick. Touch
        # feedback has its own priority queue so warning blinks cannot delay a
        # newly visited tile turning yellow.
        self._led_update_queue: OrderedDict[str, dict[str, Any]] = OrderedDict()
        self._priority_led_update_queue: OrderedDict[str, dict[str, Any]] = OrderedDict()
        self._led_update_ready = threading.Condition()
        self._led_update_worker: threading.Thread | None = None
        # Servo drops are much slower than tracking because each PCA board must
        # be selected, settled, and released. Run them independently too.
        self._motion_update_queue: OrderedDict[str, dict[str, Any]] = OrderedDict()
        self._motion_update_ready = threading.Condition()
        self._motion_update_worker: threading.Thread | None = None

    def initialize(self) -> None:
        with self._state_lock:
            if self.ready:
                self.error = ""
                return
            self.busy = True
            self.error = ""
        try:
            led_cfg, servo_grid_cfg, servo_configs = load_table_configs()
            self._validate_calibration(led_cfg, servo_grid_cfg, servo_configs)
            normalized_cells = {}
            for key, value in servo_grid_cfg.get("cells", {}).items():
                if not value:
                    continue
                normalized_cells[key] = {
                    "address": normalize_addr(value["address"]),
                    "channel": value["channel"],
                }
            servo_grid_cfg = {**servo_grid_cfg, "cells": normalized_cells}
            servo_configs = {
                normalize_addr(address): config for address, config in servo_configs.items()
            }

            link = Link(self.port, self.baud, dry_run=self.dry_run)
            link.open_wait()
            table = Table(
                link,
                led_cfg,
                servo_grid_cfg,
                servo_configs,
                module_start_delay_s=self.module_start_delay_s,
            )
            with self._io_lock:
                table.apply_led_counts()
                table.all_off()
            self.link = link
            self.table = table
            self._start_led_update_worker()
            self._start_motion_update_worker()
            with self._state_lock:
                self.ready = True
        except Exception as exc:
            self.error = str(exc)
            if self.link:
                self.link.close()
            self.link = None
            self.table = None
            raise HardwareError(str(exc)) from exc
        finally:
            with self._state_lock:
                self.busy = False

    @staticmethod
    def _validate_calibration(
        led_cfg: dict[str, Any],
        servo_grid_cfg: dict[str, Any],
        servo_configs: dict[str, Any],
    ) -> None:
        expected = {f"{row},{col}" for row in range(12) for col in range(12)}
        led_cells = set(led_cfg.get("cells", {}))
        servo_cells = set(servo_grid_cfg.get("cells", {}))
        problems: list[str] = []
        if led_cells != expected:
            problems.append(f"LED map covers {len(led_cells)}/144 cells")
        if servo_cells != expected:
            problems.append(f"servo map covers {len(servo_cells)}/144 cells")
        if len(led_cfg.get("strips", {})) != 9:
            problems.append(f"LED config defines {len(led_cfg.get('strips', {}))}/9 strands")

        missing_positions = []
        for key, location in servo_grid_cfg.get("cells", {}).items():
            if not location:
                missing_positions.append(f"{key}: no location")
                continue
            address = normalize_addr(location["address"])
            channel = str(location["channel"])
            servo = servo_configs.get(address, {}).get("servos", {}).get(channel, {})
            missing = {"recessed", "neutral", "extended"} - set(servo)
            if missing:
                missing_positions.append(
                    f"{key} {address}/ch{channel}: {','.join(sorted(missing))}"
                )
        if missing_positions:
            problems.append(
                f"{len(missing_positions)} servo envelopes incomplete "
                f"({'; '.join(missing_positions[:3])})"
            )
        if problems:
            raise HardwareError("; ".join(problems))

    def load_level(
        self, map_path: Path, start_cell: str, end_cell: str | None
    ) -> None:
        if not self.ready or not self.table:
            raise HardwareError("module grid is not initialized")
        self._stop_animations()
        self._clear_led_updates()
        self._clear_motion_updates()
        with self._state_lock:
            if self.busy:
                raise HardwareError("module grid is already loading")
            self.busy = True
            self.playing = False
            self.error = ""
            self.level = map_path.name
            self._load_phase = "starting"
            self._generation += 1
            generation = self._generation
        threading.Thread(
            target=self._load_worker,
            args=(Path(map_path), start_cell, end_cell, generation),
            name="arcade-level-loader",
            daemon=True,
        ).start()

    def _load_worker(
        self, map_path: Path, start_cell: str, end_cell: str | None, generation: int
    ) -> None:
        assert self.table is not None
        try:
            # pause() releases servos asynchronously so the UI can leave a
            # game immediately. Hardware loading still waits for that safety
            # operation before applying the next map.
            self._servo_release_done.wait()
            raw = json.loads(map_path.read_text(encoding="utf-8"))
            raw = copy.deepcopy(raw)
            raw[start_cell]["color"] = START_COLOR
            if end_cell is not None:
                raw[end_cell]["color"] = END_COLOR
            static, dynamic = parse_map(raw)
            blink_entries = [self._entry(start_cell, value=-1, color=START_COLOR)]
            for key, cell in raw.items():
                if not isinstance(cell, dict) or not cell.get("blinkUntilPlay"):
                    continue
                if key == start_cell:
                    continue
                blink_entries.append(
                    self._entry(key, value=-1, color=str(cell.get("color", "#001FFF")))
                )
            blink_keys = {entry["key"] for entry in blink_entries}
            initial = [
                cell for cell in (static + dynamic) if cell["key"] not in blink_keys
            ] + blink_entries
            if generation != self._generation:
                return
            self._load_phase = "raising"
            raised = [{**cell, "value": 1} for cell in initial]
            with self._io_lock:
                self.table.apply_cells(raised)
            if generation != self._generation:
                return
            self._load_phase = "applying"
            with self._io_lock:
                self.table.apply_cells(initial)
            self._load_phase = "applied"
            if generation != self._generation:
                return
            self._blink_entries = blink_entries
            self._dynamic = dynamic
            self._play_started_at = None
            self._start_blink(generation)
            self._load_phase = "ready"
        except Exception as exc:
            with self._state_lock:
                self.error = str(exc)
                self._load_phase = "error"
        finally:
            with self._state_lock:
                if generation == self._generation:
                    self.busy = False

    def _entry(self, key: str, value: int, color: str) -> dict[str, Any]:
        row, col = cell_key_to_row_col(key)
        return {
            "key": key,
            "row": row,
            "col": col,
            "value": value,
            "color": color,
            "rgb": (0, 0, 0),
        }

    def _start_blink(self, generation: int) -> None:
        self._animation_stop.clear()

        def blink() -> None:
            assert self.table is not None
            on = True
            while (
                not self._stop.is_set()
                and not self._animation_stop.wait(0.42)
                and generation == self._generation
                and not self.playing
            ):
                with self._io_lock:
                    for entry in self._blink_entries:
                        visible_entry = entry if on else {**entry, "color": "#000000"}
                        rgb = self.table.cell_led_rgb(visible_entry)
                        self.table.set_led(entry["row"], entry["col"], rgb)
                on = not on

        threading.Thread(target=blink, name="arcade-start-blink", daemon=True).start()

    def begin_play(self) -> None:
        if not self.table or not self._blink_entries:
            raise HardwareError("level is not prepared")
        self._animation_stop.set()
        neutral_entries = [{**entry, "value": 0} for entry in self._blink_entries]
        with self._io_lock:
            self.table.apply_cells(neutral_entries)
        with self._state_lock:
            self.playing = True
        self._play_started_at = time.monotonic()
        self._start_dynamic_loop(self._generation)

    def _start_dynamic_loop(self, generation: int) -> None:
        if not self._dynamic:
            return
        now = time.monotonic()
        play_started = self._play_started_at or now
        dynamic = copy.deepcopy(self._dynamic)
        for cell in dynamic:
            if cell.get("dyn_type", "cycle") == "cycle":
                cell["next_t"] = now + cell["interval_s"]

        def animate() -> None:
            assert self.table is not None
            while (
                not self._stop.is_set()
                and generation == self._generation
                and self.playing
            ):
                now_t = time.monotonic()
                updates = tick_dynamic_cells(
                    dynamic,
                    now_t,
                    play_started=play_started,
                )
                if updates:
                    with self._io_lock:
                        self.table.apply_cells(updates)
                time.sleep(0.05)

        threading.Thread(target=animate, name="arcade-dynamic-tiles", daemon=True).start()

    def pause(self) -> None:
        with self._state_lock:
            self.playing = False
        self._clear_led_updates()
        self._clear_motion_updates()
        self._animation_stop.set()
        self._release_servos_async()

    def cancel_load(self) -> None:
        """Abort an in-flight level load without disturbing an active play session."""
        with self._state_lock:
            if not self.busy:
                return
            self._generation += 1
            self.playing = False
            self.busy = False
            self._blink_entries = []
            self._dynamic = []
            self._play_started_at = None
        self._animation_stop.set()
        self._clear_led_updates()
        self._clear_motion_updates()
        self._release_servos()

    def apply_cell_updates(self, updates: list[dict[str, Any]]) -> None:
        if not updates or not self.table:
            return
        with self._state_lock:
            if not self.playing:
                return
        led_updates = [update for update in updates if update.get("leds_only")]
        motion_updates = [update for update in updates if not update.get("leds_only")]
        if led_updates:
            self._enqueue_led_updates(led_updates)
        if motion_updates:
            self._enqueue_motion_updates(motion_updates)

    def apply_cell_updates_now(self, updates: list[dict[str, Any]]) -> None:
        if not updates or not self.table:
            return
        with self._state_lock:
            if not self.playing:
                return
        # Finish-cell drops must complete before GameEngine.pause() clears the
        # asynchronous motion queue.
        with self._io_lock:
            self.table.apply_cells(updates)

    def _start_led_update_worker(self) -> None:
        if self._led_update_worker is not None and self._led_update_worker.is_alive():
            return

        def drain_led_updates() -> None:
            while not self._stop.is_set():
                with self._led_update_ready:
                    ready = self._led_update_ready.wait_for(
                        lambda: (
                            self._stop.is_set()
                            or self._priority_led_update_queue
                            or self._led_update_queue
                        ),
                        timeout=0.5,
                    )
                    if self._stop.is_set():
                        return
                    if not ready:
                        continue
                    with self._state_lock:
                        effect_busy = self._effect_busy
                    if effect_busy:
                        # A full-board flash ends with its restore fill. Keep
                        # per-cell updates queued so that new food/tiles are
                        # applied after that fill instead of being overwritten.
                        self._led_update_ready.wait(timeout=0.02)
                        continue
                    queue = (
                        self._priority_led_update_queue
                        if self._priority_led_update_queue
                        else self._led_update_queue
                    )
                    updates = [queue.popitem(last=True)[1]]
                with self._state_lock:
                    playing = self.playing
                if not playing or self.table is None:
                    continue
                try:
                    # LP commands do not touch the selected PCA board, and Link
                    # serializes individual writes. Do not wait behind a servo
                    # board's 450 ms settle period.
                    self.table.apply_cells(updates, leds_only=True)
                except Exception as exc:
                    self.error = str(exc)

        self._led_update_worker = threading.Thread(
            target=drain_led_updates,
            name="arcade-led-updates",
            daemon=True,
        )
        self._led_update_worker.start()

    def _enqueue_led_updates(self, updates: list[dict[str, Any]]) -> None:
        with self._led_update_ready:
            for update in updates:
                key = str(update["key"])
                priority = bool(update.get("led_priority"))
                selected = (
                    self._priority_led_update_queue
                    if priority
                    else self._led_update_queue
                )
                other = (
                    self._led_update_queue
                    if priority
                    else self._priority_led_update_queue
                )
                other.pop(key, None)
                selected[key] = update
                selected.move_to_end(key)
            while (
                len(self._priority_led_update_queue) + len(self._led_update_queue)
                > LED_UPDATE_QUEUE_CAPACITY
            ):
                queue = self._led_update_queue or self._priority_led_update_queue
                queue.popitem(last=False)
            self._led_update_ready.notify()

    def _clear_led_updates(self) -> None:
        with self._led_update_ready:
            self._led_update_queue.clear()
            self._priority_led_update_queue.clear()

    def _start_motion_update_worker(self) -> None:
        if (
            self._motion_update_worker is not None
            and self._motion_update_worker.is_alive()
        ):
            return

        def drain_motion_updates() -> None:
            while not self._stop.is_set():
                with self._motion_update_ready:
                    ready = self._motion_update_ready.wait_for(
                        lambda: self._stop.is_set() or self._motion_update_queue,
                        timeout=0.5,
                    )
                    if self._stop.is_set():
                        return
                    if not ready:
                        continue
                    updates = list(self._motion_update_queue.values())
                    self._motion_update_queue.clear()
                with self._state_lock:
                    playing = self.playing
                if not playing or self.table is None:
                    continue
                try:
                    with self._io_lock:
                        self.table.apply_cells(updates)
                except Exception as exc:
                    self.error = str(exc)

        self._motion_update_worker = threading.Thread(
            target=drain_motion_updates,
            name="arcade-motion-updates",
            daemon=True,
        )
        self._motion_update_worker.start()

    def _enqueue_motion_updates(self, updates: list[dict[str, Any]]) -> None:
        with self._motion_update_ready:
            for update in updates:
                key = str(update["key"])
                self._motion_update_queue[key] = update
                self._motion_update_queue.move_to_end(key)
            while len(self._motion_update_queue) > MOTION_UPDATE_QUEUE_CAPACITY:
                self._motion_update_queue.popitem(last=False)
            self._motion_update_ready.notify()

    def _clear_motion_updates(self) -> None:
        with self._motion_update_ready:
            self._motion_update_queue.clear()

    def unstick_cell(self, row: int, col: int) -> bool:
        if not self.table:
            return False
        with self._state_lock:
            if not self.playing or self._unstick_busy:
                return False
            self._unstick_busy = True

        def worker() -> None:
            try:
                with self._io_lock:
                    self.table.unstick_cell(
                        row,
                        col,
                        **self.unstick_config,
                    )
            except Exception as exc:
                self.error = str(exc)
            finally:
                with self._state_lock:
                    self._unstick_busy = False

        threading.Thread(
            target=worker,
            name="arcade-unstick",
            daemon=True,
        ).start()
        return True

    def flash_all_leds(
        self,
        duration_s: float = 1.0,
        restore_color: str = "#567DBB",
    ) -> bool:
        if not self.table:
            return False
        with self._state_lock:
            if not self.playing or self._effect_busy:
                return False
            self._effect_busy = True

        def worker() -> None:
            try:
                with self._io_lock:
                    step_s = max(0.05, duration_s / 2.0)
                    for index in range(2):
                        self.table.fill_all_leds_calibrated(
                            "#00FFFF" if index % 2 == 0 else "#000000"
                        )
                        if not self.dry_run:
                            time.sleep(step_s)
                    # The initial map load resolves every LED through its
                    # per-cell calibration. Do the same after a board flash;
                    # one averaged RGB makes later Food Frenzy rounds visibly
                    # inconsistent with round one.
                    self.table.fill_all_leds_calibrated(restore_color)
            except Exception as exc:
                self.error = str(exc)
            finally:
                with self._state_lock:
                    self._effect_busy = False
                with self._led_update_ready:
                    self._led_update_ready.notify_all()

        threading.Thread(
            target=worker,
            name="arcade-led-celebration",
            daemon=True,
        ).start()
        return True

    def _release_servos(self) -> None:
        if not self.link:
            return
        with self._io_lock:
            for address in BOARD_ORDER:
                self.link.select_board(address)
                self.link.send("X")

    def _release_servos_async(self) -> None:
        with self._servo_release_lock:
            if not self._servo_release_done.is_set():
                return
            self._servo_release_done.clear()

        def worker() -> None:
            try:
                self._release_servos()
            except Exception as exc:
                self.error = str(exc)
            finally:
                self._servo_release_done.set()

        threading.Thread(
            target=worker,
            name="arcade-servo-release",
            daemon=True,
        ).start()

    def _stop_animations(self) -> None:
        with self._state_lock:
            self.playing = False
            self._generation += 1
        self._animation_stop.set()
        time.sleep(0.06)

    def shutdown(self) -> None:
        self._stop.set()
        with self._led_update_ready:
            self._led_update_ready.notify_all()
        with self._motion_update_ready:
            self._motion_update_ready.notify_all()
        self._stop_animations()
        if self.table:
            try:
                with self._io_lock:
                    self.table.all_off()
            except Exception:
                pass
        if self.link:
            self.link.close()
        with self._state_lock:
            self.ready = False
            self.busy = False
            self.playing = False

    def snapshot(self) -> dict[str, Any]:
        with self._state_lock:
            return {
                "mode": "dry-run" if self.dry_run else "hardware",
                "ready": self.ready,
                "busy": self.busy,
                "playing": self.playing,
                "unstickBusy": self._unstick_busy,
                "effectBusy": self._effect_busy,
                "error": self.error,
                "level": self.level,
                "loadPhase": self._load_phase,
                "ledQueueDepth": (
                    len(self._priority_led_update_queue) + len(self._led_update_queue)
                ),
                "motionQueueDepth": len(self._motion_update_queue),
                "port": self.port,
            }
