TiltyTable/tiltytable/hardware/run_control_center.py

#!/usr/bin/env python3

import sys
from pathlib import Path

PROJECT_ROOT = Path(__file__).resolve().parents[1]
if str(PROJECT_ROOT) not in sys.path:
    sys.path.insert(0, str(PROJECT_ROOT))

from hardware.control_center.server import main


if __name__ == "__main__":
    raise SystemExit(main())
