TiltyTable/tiltytable/capture_usb_mouse.py

#!/usr/bin/env python3
"""Capture raw Linux input events from a USB mouse-like device.

This script uses only the Python standard library. It reads /dev/input/event*
records directly, so it works even when python-evdev is not installed.
"""

from __future__ import annotations

import argparse
import os
import select
import struct
import sys
import time
from pathlib import Path


EVENT_ROOT = Path("/dev/input")
PROC_INPUT_DEVICES = Path("/proc/bus/input/devices")

EV_SYN = 0x00
EV_KEY = 0x01
EV_REL = 0x02
EV_ABS = 0x03
EV_MSC = 0x04

REL_CODES = {
    0x00: "REL_X",
    0x01: "REL_Y",
    0x02: "REL_Z",
    0x06: "REL_HWHEEL",
    0x08: "REL_WHEEL",
    0x0B: "REL_WHEEL_HI_RES",
    0x0C: "REL_HWHEEL_HI_RES",
}

KEY_CODES = {
    0x110: "BTN_LEFT",
    0x111: "BTN_RIGHT",
    0x112: "BTN_MIDDLE",
    0x113: "BTN_SIDE",
    0x114: "BTN_EXTRA",
    0x115: "BTN_FORWARD",
    0x116: "BTN_BACK",
    0x117: "BTN_TASK",
}

EVENT_TYPES = {
    EV_SYN: "EV_SYN",
    EV_KEY: "EV_KEY",
    EV_REL: "EV_REL",
    EV_ABS: "EV_ABS",
    EV_MSC: "EV_MSC",
}

# Linux input_event is timeval + unsigned short + unsigned short + signed int.
# Native layout handles 64-bit Jetson kernels and other Linux ABIs correctly.
INPUT_EVENT = struct.Struct("llHHI")

BAUD_RATES = (9600, 19200, 38400, 57600, 115200)


class StewartController:
    def __init__(
        self,
        port: str | None,
        baud: int,
        heave_mm: float,
        dry_run: bool,
        response_wait_s: float,
        verbose: bool,
    ) -> None:
        self.port = port
        self.baud = baud
        self.heave_mm = heave_mm
        self.dry_run = dry_run
        self.response_wait_s = response_wait_s
        self.verbose = verbose
        self.ser = None
        self.fd: int | None = None

    def open(self) -> None:
        if self.dry_run:
            print("Dry run: serial port will not be opened.")
            return
        if not self.port:
            return

        # Import here so --list / HID-only use still works without cwd issues.
        # Under `sudo python3` the system interpreter often lacks pyserial —
        # use: sudo /path/to/.venv/bin/python3 capture_usb_mouse.py ...
        try:
            from stewart_serial import open_stewart_serial
        except ModuleNotFoundError as exc:
            raise RuntimeError(
                "pyserial not found in this Python. "
                "Don't use bare `sudo python3` (system Python). "
                "Run: sudo ~/tiltytable/.venv/bin/python3 capture_usb_mouse.py ..."
            ) from exc

        self.ser = open_stewart_serial(self.port, self.baud, timeout=self.response_wait_s)
        self.fd = self.ser.fileno()
        from stewart_serial import wait_if_reset

        # ACM open almost always resets the Uno — always allow boot time.
        reset = wait_if_reset(self.ser, wait_s=2.2)
        if not reset:
            # Boot banner missed (already drained) — still give the board time.
            time.sleep(2.2)
        if self.verbose:
            print("arduino: serial open complete (Uno may have reset; will recalibrate if requested)")
        startup = read_available(self.fd, 0.2).strip()
        if startup and self.verbose:
            print_prefixed("arduino: ", startup)

    def close(self) -> None:
        if self.ser is not None:
            try:
                self.ser.close()
            except Exception:
                pass
            self.ser = None
            self.fd = None

    def can_send(self) -> bool:
        return self.dry_run or self.ser is not None

    def send(self, command: str, response_wait_s: float | None = None) -> str:
        line = command.rstrip() + "\n"
        if self.dry_run or not self.port:
            print(f"arduino <= {line.strip()}")
            return ""
        if self.ser is None:
            raise RuntimeError("serial port is not open")

        wait = self.response_wait_s if response_wait_s is None else response_wait_s
        self.ser.reset_input_buffer()
        self.ser.write(line.encode("ascii"))
        self.ser.flush()
        response = read_available(self.fd, wait).strip()
        if response and self.verbose:
            print_prefixed("arduino: ", response)
        if "ERR" in response:
            raise RuntimeError(response)
        return response
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
