TiltyTable/tiltytable/(commit log)

2026-07-09 Consolidate calibration suite, hardware stack, and design docs
    Fold in the grid-based calibration/runtime tools (tilt_table_cli, servo/LED
    cal tools and per-module configs), the Flask hardware control center, the
    project site and design/planning docs, and refresh the servo firmware and
    LED scripts to their latest versions.
    [hardware_config.yaml, servo_calibration.json, servo_config_0x40.json, servo_config_0x41.json, servo_config_0x42.json, servo_config_0x43.json, servo_config_0x44.json, servo_config_0x45.json]
2026-07-09 Align Stewart pinout and board roles; add camera probe path
    Update the Uno R3 Stewart firmware to DIR 3/6/11, PLS 2/5/10, ENA 4/7/12,
    rename udev aliases to arduino-stewart / arduino-modules, fix README board
    roles, add shared requirements, and scaffold MindVision HT-SUA134GM capture
    docs/probe until the ARM64 SDK is installed.
    [uim5756pm_stewart.ino]
2026-07-09 Update memory bank for Jetson bring-up status
    Record board roles, Stewart pinout flash, smoke-test results, and the
    MindVision SDK gap so the next session starts from current hardware state.
2026-07-09 Add Cursor rules to prevent repeated hardware and git mistakes
    Encode board roles, Stewart pinout, Jetson-only push/rsync pitfalls,
    hardware safety defaults, and updated techContext so future sessions
    do not relearn the wrong Arduino mapping or overwrite remotes.
2026-07-09 Enable MindVision HT-SUA134GM capture on Jetson
    Install path documented; vendor mvsdk.py binding checked in; capture helper
    enumerates the USB3 camera and saves a 1280x1024 mono frame.
2026-07-09 Update memory bank after MindVision first-frame success
    Also ignore SDK-created Camera/ runtime data directory.
2026-07-09 Add MindVision live MJPEG focus preview stream
    Browser UI on :8090 with exposure controls and center crosshair so the
    lens can be focused from any LAN machine.
2026-07-09 Fix gitignore so camera/ source is tracked
    A case-insensitive match on Camera/ was ignoring the camera/ package.
    Ignore only the SDK runtime /Camera/ directory at repo root.
2026-07-09 Ignore only MindVision SDK Camera/Data and Camera/log dirs
2026-07-09 Require Stewart calibrate at cranks-up (max heave)
    Boot no longer assumes a known pose. Human points all cranks straight up,
    then `calibrate` (alias `zero`) sets that as the step/heave reference and
    gates enable/pose/jog until done. Add stewart_calibrate.py helper.
    [capture_usb_mouse.py, stewart_calibrate.py, uim5756pm_stewart.ino]
2026-07-09 Update memory bank for Stewart calibrate flow
2026-07-11 the table is calibrated
    [servo_config_0x40.json, servo_config_0x41.json, servo_config_0x42.json, servo_config_0x43.json, servo_config_0x44.json, servo_config_0x45.json, servo_config_0x46.json, servo_config_0x47.json]
2026-07-13 Add Jetson arcade game flow
    Build a self-contained 480p cabinet experience with safe module-grid orchestration, scored progression, and local persistence.
    [servo_config_0x40.json, servo_config_0x41.json, servo_config_0x47.json, servo_grid_config.json]
2026-07-14 Extend arcade for Open Sauce booth: survival mode, levels 4–7, and grid calibration.
    Adds survival lava gameplay, ball/Kinect adapters, seven arcade levels, LED color calibration tools, module grid mapping rules, and archives superseded Arduino firmware under arduino/archive/.
2026-07-16 Cursor: Apply local changes for cloud agent
    [servo_calibration.json]
2026-07-16 Prevent infinite Snake target farming
    [test_arcade_editor.py]
2026-07-16 Harden Stewart control and calibration
2026-07-16 remove servo code from kinect_web_control
2026-07-16 Route kiosk launches to the cabinet projector
    Treat SSH-forwarded displays as remote so the integrated runner always opens on the Jetson's local HDMI screen.
2026-07-16 Simplify Kinect table cell mapping
    Use six fiducials and an image homography to map ball pixels directly to cells, removing the IMU and 3D pose path from the tracking loop.
2026-07-17 update calibration
    [servo_config_0x45.json, servo_config_0x48.json]
2026-07-17 speed up game loop
    [servo_config_0x45.json]
2026-07-17 Code works no touchie
    [servo_config_0x43.json]
2026-07-18 add in maze level and editor
    [servo_config_0x42.json]
2026-07-18 servo updates, raise before reset
    [servo_config_0x41.json, servo_config_0x42.json, servo_config_0x43.json, servo_config_0x45.json, servo_config_0x46.json, servo_config_0x47.json]
2026-07-18 UI updates
    [servo_config_0x43.json]
2026-07-19 end of day sat checkpoint
    [servo_config_0x41.json, servo_config_0x43.json, servo_config_0x44.json, servo_config_0x45.json, servo_config_0x46.json, servo_config_0x48.json]
